youziawa/2026-EDC/GroundStation/Software/README.md

# LXS1 陆空协同地面站

面向 2026 电赛 D 题的离线地面站。程序可通过透明无线串口接收 LXS1
协议遥测，在赛题场地图上叠加小车与无人机位置，并显示任务、飞控、抛投、
降落和故障状态。程序不需要联网。

## 功能

- Windows / Ubuntu 图形界面
- 飞机/小车双串口独立扫描、连接、断线提示和收发计数
- LXS1 增量解析，可处理粘包、分包和错误帧
- 打印用场地图实时轨迹、无人机/小车位置与航向
- 任务计时、飞机/小车坐标、飞控状态、速度、里程、圈数、链路新鲜度
- 事件日志、原始帧监视、CSV 遥测自动记录

## 安装与启动

需要 Python 3.10 或更高版本。

Windows PowerShell：

```powershell
cd GroundStation\Software
py -m pip install -r requirements.txt
py main.py
```

Windows 下也可以直接双击 `启动地面站.bat`。它会在首次运行时自动创建
`.venv` 虚拟环境并安装依赖，后续双击即可启动。

Ubuntu：

```bash
sudo apt install python3 python3-tk
cd GroundStation/Software
python3 -m pip install -r requirements.txt
python3 main.py
```

也可以运行 `start_windows.bat` 或 `sh start_linux.sh`。首次启动会按依赖清单安装
`pyserial`；串口连接需要相应设备及驱动可用。

## 串口与坐标约定

- 飞机和小车各使用一个独立串口，两个串口可同时连接；默认参数均为
  115200、8 数据位、无校验、1 停止位。
- 地图坐标原点为场地左下角，X 向右（0~400 cm），Y 向上（0~500 cm）。
- 小车显示位置不直接采用 `CAR_POSE`，而是用累计里程沿赛题轨迹换算。
  起点为 A，方向为 A→B→C→D→A，每圈约 771.24 cm。
- `CAR_STATE.path_cm` 和 `TASK_STATE.car_path_mm` 均可驱动里程位置更新。
- 当前小车固件的 13 字节 `CAR_STATE` 使用
  `run_id/state/speed_mode/line_valid/speed_mm_s/fault/path_mm/lap_complete`
  布局；地面站优先采用其中的 `path_mm`，同时兼容旧版 7 字节帧。
- 飞机 F407 通过蓝牙串口以 10 Hz 发送 `FC_POSE(0x22)`，数据固定为
  `<hh>`：`x_cm, y_cm`（小端、有符号 16 位）。地面站收到后实时更新飞机坐标和轨迹。
- 飞机上传坐标以地图中的 H 点为 `(0,0)`；绘图换算为
  `map_x=112.5-y`、`map_y=112.5+x`。界面数值仍显示飞机上传的原始 X/Y。
- 地面站界面不显示飞机电量与高度。

每次启动程序都会在 `logs/` 中创建 CSV 遥测文件。该目录不会上传网络。

## 验证

```bash
python -m unittest discover -s tests -v
```
