youziawa/2026-EDC/Car/STM32/CarF407/firmware/README.md

# 小车STM32固件

`CarF407.elf`由本仓库 `Car/STM32/CarF407` 的Debug预设构建。

```text
SHA256: C8B3D5FA0F634D9365EC351CBA59D4C3C60BECCAF04A248F474D092485555132
FLASH:  37600 bytes
RAM:    4912 bytes
```

烧录目标：STM32F407VET6。OpenOCD配置见上级目录 `lckfb-skystar.cfg`。
