youziawa/2026-EDC/THIRD_PARTY_NOTICES.md

# 第三方组件与许可说明

根目录 [LICENSE](LICENSE) 中的 MIT 协议仅适用于本竞赛团队拥有版权的原创代码和文档。它不改变、替代或扩展第三方组件的原始许可。

| 组件 | 位置 | 说明 |
|---|---|---|
| STM32Cube HAL 与 CMSIS | `Air/STM32/AirF407/Drivers`、`Car/STM32/CarF407/Drivers` | 保留组件目录内的原始 `LICENSE.txt`；使用、修改与再分发须遵循原始许可。 |
| 凌霄飞控工程及其依赖 | `Air/Lingxiao/` | 仅为竞赛复现保留；版权及再分发条件由其原作者/供应商的许可决定。 |
| 其他开发板固件、SDK 和二进制库 | 相关工程目录 | 依其随附许可证或上游许可证执行。 |

若准备将本项目用于产品、商用交付或独立再发布，请先逐项确认上述组件的授权范围。
