youziawa/2026-EDC/Car/硬件基线.md

# 小车系统硬件基线

> 本文件记录用户已经确认的实际硬件。后续进行接线分配、CubeMX配置、
> 驱动代码编写和故障排查时，均以本文件为优先依据，不再按同类通用模块猜测。

## 已确认设备

| 类别 | 品牌/型号 | 说明 |
|---|---|---|
| 小车主控 | 天空星 STM32F407VET6 开发板 | MCU为STM32F407VET6，LQFP100封装 |
| 电机驱动 | 成品TB6612电机驱动板 | 使用外接成品模块，不是底板直接焊接TB6612芯片，也不再使用AT8236 |
| 驱动电机 | 轮趣MG310MGR编码器电机 | 两只电机用于双主动轮差速驱动；型号字符串按用户确认为“MG310MGR” |
| 小车视觉 | 亚博K230摄像头 | 负责小车端视觉识别，并通过串口与STM32F407通信 |

## 当前K230串口接线

| K230端 | STM32F407端 |
|---|---|
| GPIO32 / UART3_TXD | PB11 / USART3_RX |
| GPIO33 / UART3_RXD | PB10 / USART3_TX |
| GND | GND |

串口为115200、8-N-1，TX与RX交叉连接。

## 当前确认的编码器接线

| 车轮 | 编码器A相 | 编码器B相 | STM32定时器 |
|---|---|---|---|
| 当前左轮（原右电机） | PB6（驱动板E1A） | PB7（驱动板E1B） | TIM4_CH1 / TIM4_CH2 |
| 当前右轮（原左电机） | PA5（驱动板E2A） | PA1（驱动板E2B） | TIM2_CH1 / TIM2_CH2 |

天空星板载 `KEY` 使用 PA0，外部下拉，松开为低电平、按下为高电平。它用于本地启动任务，不再与编码器复用。

## 当前车轮标定

| 项目 | 实测值 |
|---|---|
| 车轮直径 | 约47 mm |
| 底板 | 高强度新版底板 |
| 两轮中心轮距 | 432 mm（43.2 cm） |
| 当前左轮编码器每圈计数 | 41589（原右电机，取绝对值） |
| 当前右轮编码器每圈计数 | 41348（原左电机，取绝对值） |
| 当前左轮每计数路程 | 约0.003550 mm |
| 当前右轮每计数路程 | 约0.003571 mm |
| 当前轮组安装方向 | 左右电机已交换，软件同步交换电机、PWM、编码器和标定参数 |

## 后续设计约束

1. STM32引脚分配必须以天空星STM32F407VET6开发板实际引出引脚为准。
2. 电机控制信号必须按照成品TB6612驱动板端子的实际标识连接：
   `PWMA`、`AIN1`、`AIN2`、`STBY`、`BIN1`、`BIN2`、`PWMB`。
3. 编码器配置必须针对轮趣MG310MGR的A/B相输出进行实测，不能套用普通低线数霍尔编码器参数。
4. K230相关代码和串口协议以亚博K230的CanMV运行环境及实际屏幕、摄像头接口为准。
5. 若后续实物型号、版本或接线发生变化，应先更新本文件，再修改软件和引脚表。

## 当前工程位置

- STM32工程：`Car/Software/CarF407`
- K230视觉工程：`Car/K230`
- 小车硬件资料：`Car/Hardware`
