youziawa/2026-EDC/Car/Hardware/小车主板.png

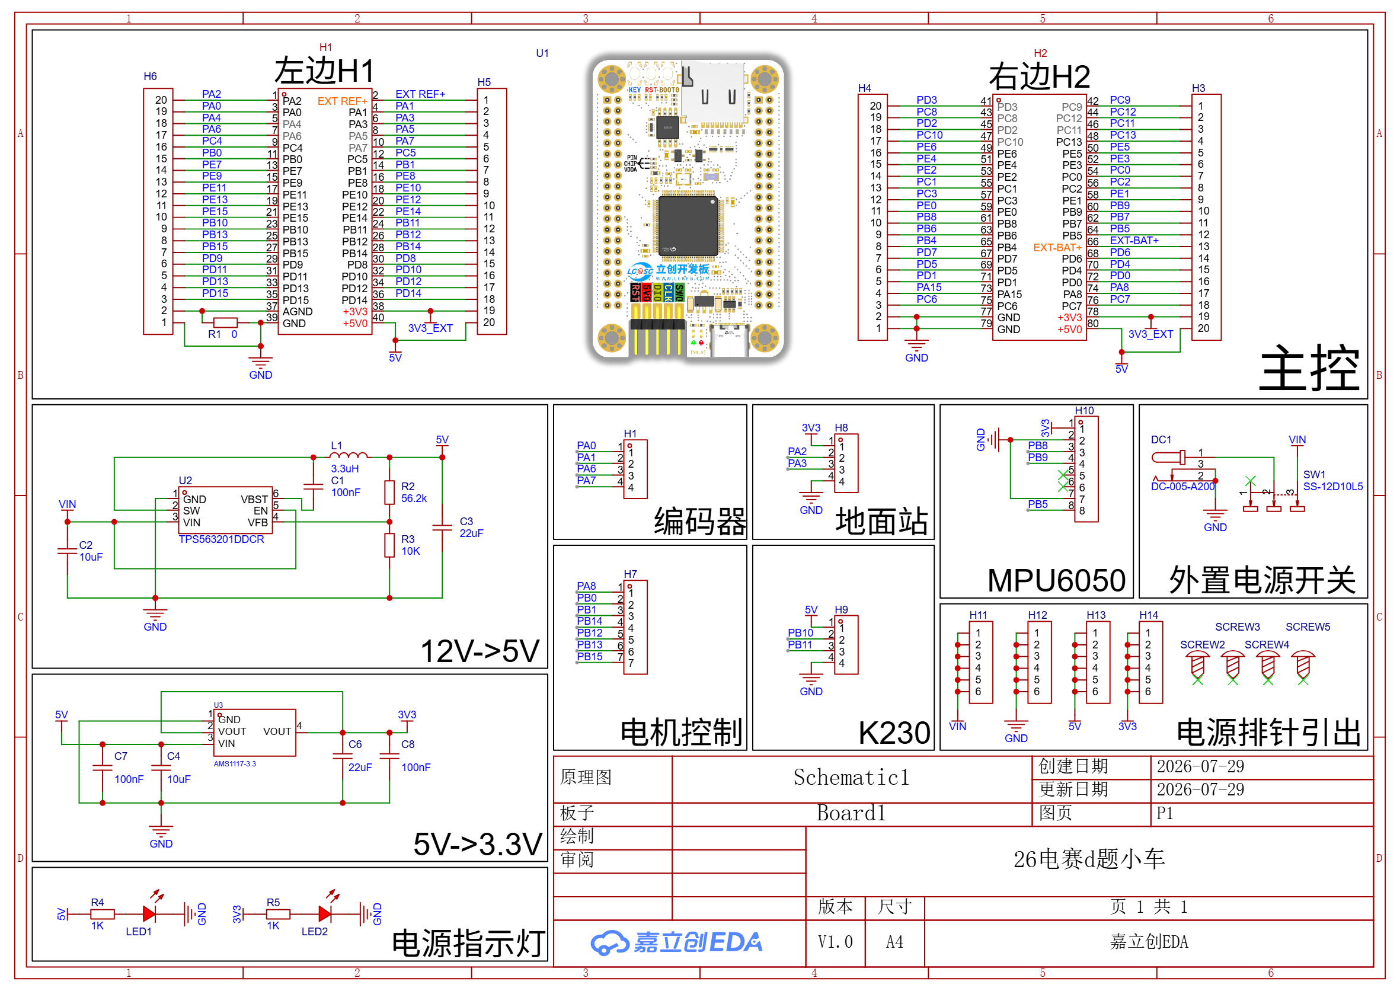
Car/Hardware/小车主板.png
