youziawa/2026-EDC/Car/Hardware/BOM_Board1_双路电机驱动板_2026-07-15.xlsx

No. | Quantity | Comment | Designator | Footprint | Value | Manufacturer Part | Manufacturer | Supplier Part | Supplier
1 | 3 | PZ254V-11-04P | 5V,12V,GND | HDR-TH_4P-P2.54-V-M |  | PZ254V-11-04P | XFCN(兴飞) | C2691448 | LCSC
2 | 6 | 100nF | C1,C2,C9,C13,C20,C21 | C0805 | 100nF
3 | 1 | 10uF | C3 | C_Ele_SMD_3x5.4mm | 10uF
4 | 2 | 47uF | C8,C12 | CAP-SMD_BD6.3-L6.6-W6.6-LS7.3-FD | 47uF | RV63V47M6X8 | JIERR(捷而瑞) | C48971005 | LCSC
5 | 1 | 10nF | C10 | C0805 | 10nF
6 | 1 | 100pF | C11 | C0805 | 100pF
7 | 1 | DC-005-A200 | DC1 | DC-IN-TH_DC-005-A200 |  | DC-005-A200 | XUNPU(讯普) | C720557 | LCSC
8 | 1 | PZ254V-12-10P | H1 | HDR-TH_10P-P2.54-V-M-R2-C5-S2.54 |  | PZ254V-12-10P | XFCN(兴飞) | C492422 | LCSC
9 | 1 | 6.8uH | L1 | IND-SMD_L4.6-W4.1_FCH0420 | 6.8uH | SRG0420-6R8-M | JIERR(捷而瑞) | C53462919 | LCSC
10 | 2 | ZX-XH2.54-6PZZ | MOTOR1,MOTOR2 | CONN-TH_6P-P2.50_ZX-XH2.54-6PZZ |  | ZX-XH2.54-6PZZ | Megastar(兆星) | C7429636 | LCSC
11 | 1 | LED_0603-R | PWR | LED_0603
12 | 1 | 200K | R1 | R0805 | 200K
13 | 2 | 10K | R2,R3 | R0805 | 10K
14 | 1 | 100K | R4 | R0805 | 100K
15 | 1 | 13.7K | R5 | R0805 | 13.7K
16 | 3 | M3螺丝 | SCREW1,SCREW2,SCREW3 | M3螺丝
17 | 1 | SS-12D10L5 | SW1 | SW-TH_SS-12D10L5 |  | SS-12D10L5 | XKB Connection(中国星坤) | C319012 | LCSC
18 | 1 | TB6612FNG(O,C,8,EL | U1 | SSOP-24_L8.4-W5.8-P0.65-LS7.8-BL |  | TB6612FNG(O,C,8,EL | TOSHIBA(东芝) | C88224 | LCSC
19 | 1 | SY8303AIC | U2 | TSOT-23-8_L2.9-W1.6-P0.65-LS2.8-BR |  | SY8303AIC | Silergy(矽力杰) | C97054 | LCSC
