youziawa/2026-EDC/Car/STM32/CarF407/Core/Src/main.c

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
/* Includes ------------------------------------------------------------------*/
#include "main.h"
#include "dma.h"
#include "i2c.h"
#include "tim.h"
#include "usart.h"
#include "gpio.h"

/* USER CODE BEGIN Includes */
#include "board_io.h"
#include "car_control.h"
#include "car_link.h"
#include "car_mission.h"
#include "car_odometry.h"
#include "k230_vision.h"
#include "line_follow.h"
/* USER CODE END Includes */


void SystemClock_Config(void);
/**
  * @brief  The application entry point.
  * @retval int
  */
int main(void)
{

  /* MCU Configuration--------------------------------------------------------*/

  /* Reset of all peripherals, Initializes the Flash interface and the Systick. */
  HAL_Init();

  /* Configure the system clock */
  SystemClock_Config();

  /* Initialize all configured peripherals */
  MX_GPIO_Init();
  MX_DMA_Init();
  MX_I2C1_Init();
  MX_TIM1_Init();
  MX_TIM2_Init();
  MX_TIM6_Init();
  MX_USART3_UART_Init();
  MX_USART2_UART_Init();
  MX_TIM12_Init();
  MX_TIM4_Init();
  MX_USART1_UART_Init();
  /* USER CODE BEGIN 2 */
  BoardKeys_Init();
  if (CarControl_Init() != HAL_OK)
  {
    Error_Handler();
  }
  LineFollow_Init();
  CarOdometry_Init();
  CarMission_Init();
  if (CarLink_Init(&huart2, &huart1) != HAL_OK)
  {
    CarControl_EmergencyStop();
    Error_Handler();
  }
  if (K230Vision_Init() != HAL_OK)
  {
    /*
     * 视觉串口启动失败时不进入Error_Handler，保留VOFA+诊断能力；
     * LineFollow_Init已经把两轮目标清零，因此小车会保持安全停车。
     */
    CarControl_EmergencyStop();
  }
  /* USER CODE END 2 */

  /* Infinite loop */
  /* USER CODE BEGIN WHILE */
  while (1)
  {
    /* USER CODE END WHILE */

    /* USER CODE BEGIN 3 */
    K230Vision_Task();
    CarLink_Task();
    CarControl_Task();
    CarOdometry_Task();
    CarMission_Task();
    LineFollow_Task();
    CarLink_Task();
  }
  /* USER CODE END 3 */
}

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
