youziawa/2026-EDC/Air/Lingxiao/ANO_LX_FC - NEW/FcSrc/LX_FC_State.c

/*==========================================================================
 * 描述    ：凌霄飞控状态处理（主要是摇杆解锁，触发校准等）
 * 更新时间：2020-03-31
 * 作者		 ：匿名科创-Jyoun
 * 官网    ：www.anotc.com
 * 淘宝    ：anotc.taobao.com
 * 技术Q群 ：190169595
 * 项目合作：18084888982，18061373080
============================================================================
 * 匿名科创团队感谢大家的支持，欢迎大家进群互相交流、讨论、学习。
 * 若您觉得匿名有不好的地方，欢迎您拍砖提意见。
 * 若您觉得匿名好，请多多帮我们推荐，支持我们。
 * 匿名开源程序代码欢迎您的引用、延伸和拓展，不过在希望您在使用时能注明出处。
 * 君子坦荡荡，小人常戚戚，匿名坚决不会请水军、请喷子，也从未有过抹黑同行的行为。
 * 开源不易，生活更不容易，希望大家互相尊重、互帮互助，共同进步。
 * 只有您的支持，匿名才能做得更好。
===========================================================================*/
#include "LX_FC_State.h"
#include "Drv_RcIn.h"
#include "ANO_DT_LX.h"
#include "LX_FC_Fun.h"

_fc_state_st fc_sta;
_sticks_fun_st sti_fun;

// 美国手，外八
#define TOE_OUT \
	(rc_in.rc_ch.st_data.ch_[ch_1_rol] > 1900 && rc_in.rc_ch.st_data.ch_[ch_2_pit] < 1100 && rc_in.rc_ch.st_data.ch_[ch_3_thr] < 1100 && rc_in.rc_ch.st_data.ch_[ch_4_yaw] < 1100) 

// 美国手，内八
#define TOE_IN \
	(rc_in.rc_ch.st_data.ch_[ch_4_yaw] > 1900 && rc_in.rc_ch.st_data.ch_[ch_2_pit] < 1100 && rc_in.rc_ch.st_data.ch_[ch_3_thr] < 1100 && rc_in.rc_ch.st_data.ch_[ch_1_rol] < 1100)

// 美国手，左下+左下
#define LD_LD \
	(rc_in.rc_ch.st_data.ch_[ch_4_yaw] < 1100 && rc_in.rc_ch.st_data.ch_[ch_2_pit] < 1100 && rc_in.rc_ch.st_data.ch_[ch_3_thr] < 1100 && rc_in.rc_ch.st_data.ch_[ch_1_rol] < 1100)

// 美国手，右下+右下
#define RD_RD \
	(rc_in.rc_ch.st_data.ch_[ch_4_yaw] > 1900 && rc_in.rc_ch.st_data.ch_[ch_2_pit] < 1100 && rc_in.rc_ch.st_data.ch_[ch_3_thr] < 1100 && rc_in.rc_ch.st_data.ch_[ch_1_rol] > 1900)

// 通道8高值，向下掰
#define UN_LOCK (rc_in.rc_ch.st_data.ch_[ch_8_aux4] > 1700 && rc_in.rc_ch.st_data.ch_[ch_8_aux4] < 2200)
#define LOCK (rc_in.rc_ch.st_data.ch_[ch_8_aux4] > 800 && rc_in.rc_ch.st_data.ch_[ch_8_aux4] < 1200)

// 摇杆触发校准水平条件
#define STICKS_CALI_HOR_REQ (LD_LD)
// 摇杆触发校准罗盘条件
#define STICKS_CALI_MAG_REQ (RD_RD)

// 摇杆解锁条件requirement
#define STICKS_UNLOCK_REQ (UN_LOCK) // 由原来#define STICKS_UNLOCK_REQ (TOE_OUT || TOE_IN)更改
// 摇杆上锁条件
#define STICKS_LOCK_REQ (LOCK)
// 解锁持续时间,毫秒
#define UNLOCK_HOLD_TIME_MS (1000)
// 上锁持续时间,毫秒
#define LOCK_HOLD_TIME_MS (300)
// 当前解锁/上锁状态
#define UNLOCK_STATE (fc_sta.unlock_sta)

//
static u16 time_dly_cnt_ms;
static u8 unlock_lock_flag;

static void LX_Unlock_Lock_Check(float *dT_s)
{
	// 判断yaw摇杆是否大致回中
	if ((rc_in.rc_ch.st_data.ch_[ch_4_yaw] > 1400 && rc_in.rc_ch.st_data.ch_[ch_4_yaw] < 1600)) // 左摇杆左右方向居中
	{
		sti_fun.stick_mit_pos = 1; // 在中位（这里说的“在不在中位”指摇杆左右方向是否回到大致中心位置。回中后才允许触发一次解锁/上锁动作，防止连击或误操作）
		unlock_lock_flag = 1;	   // 回中以后才能执行一次解锁或者上锁
	}
	else
	{
		sti_fun.stick_mit_pos = 0; // 不在中位
	}
	// 标记预备上锁的动作
	if (rc_in.rc_ch.st_data.ch_[ch_3_thr] < 1200 && (sti_fun.stick_mit_pos == 0)) // 油门低且yaw不在中位
	{
		sti_fun.pre_locking = 1; // 预备上锁
	}
	else
	{
		sti_fun.pre_locking = 0; // 取消预备上锁
	}
	// 解锁
	if (unlock_lock_flag == 1) // 执行条件
	{
		if (UNLOCK_STATE == 0) // 当前为上锁状态
		{
			if (STICKS_UNLOCK_REQ) // 满足解锁条件,通道8向下掰
			{
				if (time_dly_cnt_ms < UNLOCK_HOLD_TIME_MS) // 持续时间未到
				{
					time_dly_cnt_ms += *(dT_s) * 1e3f; // 累加时间
				}
				else // 持续时间到，执行解锁
				{
					FC_Unlock(); // 解锁
					time_dly_cnt_ms = 0;
					unlock_lock_flag = 0; // 不再执行
				}
			}
			else // 不满足解锁条件
			{
				time_dly_cnt_ms = 0; // 清零时间
			}
		}
		else if (UNLOCK_STATE == 1) // 当前为解锁状态
		{
			if (STICKS_LOCK_REQ) // 满足上锁条件
			{
				if (time_dly_cnt_ms < LOCK_HOLD_TIME_MS)
				{
					time_dly_cnt_ms += *(dT_s) * 1e3f;
				}
				else
				{
					FC_Lock(); // 上锁
					time_dly_cnt_ms = 0;
					unlock_lock_flag = 0; // 不再执行
				}
			}
			else
			{
				time_dly_cnt_ms = 0;
			}
		}
	}
	else
	{
		// null
	}
}

void LX_Cali_Trig_Check() // 摇杆触发校准检测
{
	static u8 cali_f;
	// 为上锁状态才执行
	if (UNLOCK_STATE == 0)
	{
		// 执行条件
		if (STICKS_CALI_HOR_REQ) // 摇杆触发校准水平条件
		{
			// 标记只执行一次
			if (cali_f == 0)
			{
				Horizontal_Calibrate();
				cali_f = 1;
			}
		}
		else if (STICKS_CALI_MAG_REQ)
		{
			if (cali_f == 0)
			{
				Mag_Calibrate();
				cali_f = 1;
			}
		}
		else
		{
			cali_f = 0;
		}
	}
}

void LX_FC_State_Task(float dT_s)
{
	// 有遥控信号才执行
	if (rc_in.fail_safe == 0)
	{
		//
		LX_Unlock_Lock_Check(&dT_s);
		//
		LX_Cali_Trig_Check();
	}
}
