youziawa/2026-EDC/Air/Lingxiao/ANO_LX_FC - NEW/DriversMcu/TM4C123/Drivers/Drv_Uart.h

#ifndef _DRV_UART_H_
#define _DRV_UART_H_
#include "sysconfig.h"

#define UartSendLXIMU DrvUart5SendBuf

void DrvUart1Init(uint32_t baudrate);
void DrvUart1SendBuf(u8 *data, u8 len);
void DrvUart2Init(uint32_t baudrate);
void DrvUart2SendBuf(u8 *data, u8 len);
u8 DrvUart2ReadPose(s16 *x, s16 *y, s16 *z, s16 *yaw);
///////////////////
u8 DrvUart5ReadMissionDone(void);
void DrvUart3Init(uint32_t baudrate);
void DrvUart3SendBuf(u8 *data, u8 len);
void DrvUart4Init(uint32_t baudrate);
void DrvUart4SendBuf(u8 *data, u8 len);
void DrvUart5Init(uint32_t baudrate);
void DrvUart5SendBuf(u8 *data, u8 len);

void DrvUartDataCheck(void);
#endif
