youziawa/2026-EDC/(commit log)

2026-07-29 添加简化版LXS1通信协议与AI Skill
2026-07-30 feat: add K230 vision and coordinated mission state machine
    [land_air_state_machine.yaml]
2026-07-30 feat: publish car system and aircraft integration handoff
    [BOM_Board1_双路电机驱动板_2026-07-15.xlsx, land_air_state_machine.yaml, lckfb-skystar.cfg]
2026-07-30 feat: add graphical ground station and integration guide
2026-07-31 feat: sync current air-car integration code
    [land_air_state_machine.yaml]
2026-08-01 feat: sync task 2 landing and return flow
2026-08-16 chore: prepare public repository release
    [mission-state-machine.yaml]
