youziawa/2026-EDC/(notices)

Notices in the files:
Car/STM32/CarF407/Core/Src/main.c:
Copyright (c) 2026 STMicroelectronics.
All rights reserved.
This software is licensed under terms that can be found in the LICENSE file
